KareemRefai/Embedded-Project-Group-8/pic1.jpg

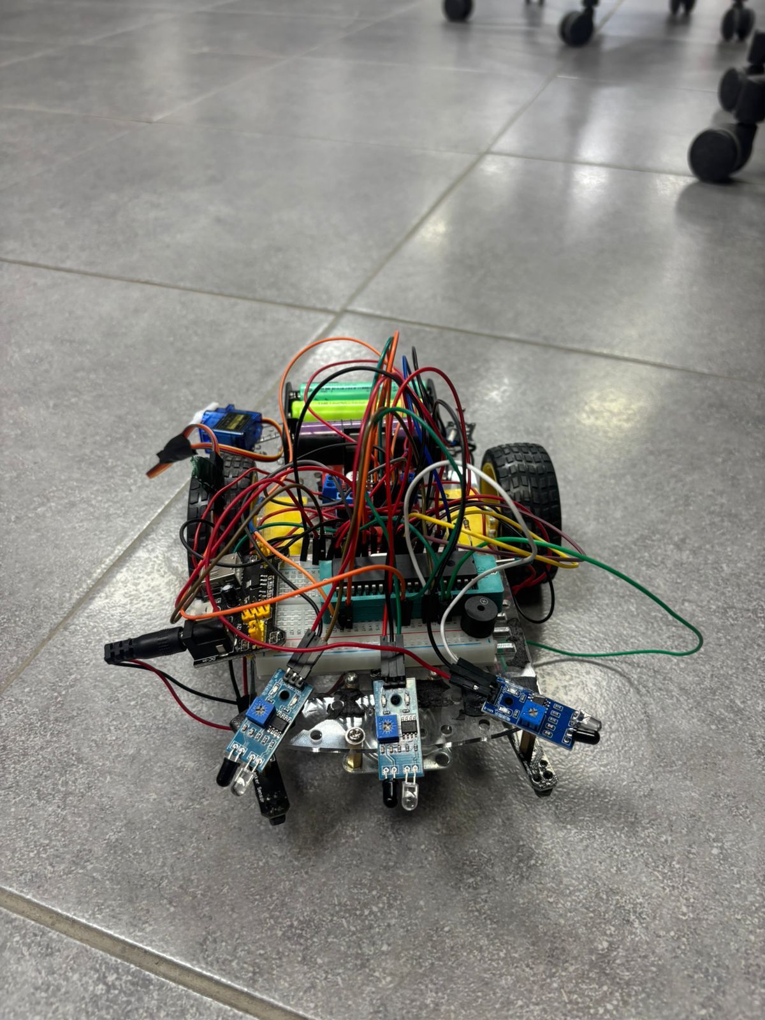
pic1.jpg
