KareemRefai/Embedded-Project-Group-8/pic2.jpg

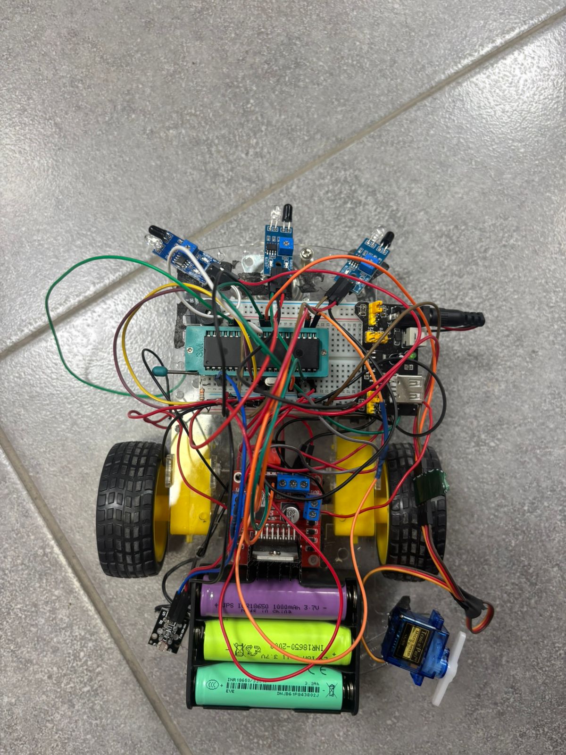
pic2.jpg
