KareemRefai/Embedded-Project-Group-8/EmbeddedActualFinalCodeForGroup8.c

void manual_delay(unsigned int d) {
    unsigned int i;
    for(i = 0; i < d; i++) {

    }
}
void timer1_delay_us(unsigned int us) {
    unsigned int preload; // initial count value

    T1CON = 0x10;          //Timer1 OFF, internal clock, prescaler 1:2

    preload = 65536 - us; //count to 2^16 before overflow

    TMR1H = preload / 256; //high byte, Timer1 high
    TMR1L = preload % 256; //low byte, Timer1 Low

    PIR1 = PIR1 & 0xFE;    //clear bit 0 (TMR1IF)

    T1CON = T1CON | 0x01;  //set bit 0 (TMR1ON)

    while((PIR1 & 0x01) == 0);

    T1CON = T1CON & 0xFE;  //clear bit 0 (T1CON)
}

unsigned int servo_i;


// ================= ADC FOR LDR ON RA1 / AN1 =================
void ADC_Init_LDR_RA1() {
    ADCON1 = 0x80; //PORTA analog inputs (right justified)
    ADCON0 = 0x49; //RA1 selected
}

unsigned int read_ldr_RA1() {
    ADCON0 = 0x49;
    manual_delay(20); //charge capacitor

    ADCON0 = ADCON0 | 0x04; //start ATD conversion

    while(ADCON0 & 0x04);

    return ((unsigned int)ADRESH * 256) + ADRESL;
}


// ================= PWM INIT =================
// ENA = RC1 = CCP2
// ENB = RC2 = CCP1

void CCPPWM_init(void) {
    TRISC = TRISC & 0xF9;

    PR2 = 250; //set pwm period register

    CCP1CON = 0x0C;
    CCP2CON = 0x0C;

    CCPR1L = 0;
    CCPR2L = 0;

    T2CON = 0x07; //start Timer2, prescaler 1:16, enable pwm signals
}


// ================= MOTOR SPEED =================

void motor_R(unsigned char speed) {
    CCPR1L = speed;
}

void motor_L(unsigned char speed) {
    CCPR2L = speed;
}


// ================= MOTOR CONTROL =================
// IN1 = RD0
// IN2 = RD1
// IN3 = RD2
// IN4 = RD3

void stop_motors() {
    PORTD = PORTD & 0xF0; //clear RD0-RD3, turn off direction

    motor_L(0);
    motor_R(0);
}

void forward() { //RD0 = 1,RD2 = 1

    PORTD = PORTD | 0x05;
    PORTD = PORTD & 0xF5;

    motor_L(55);
    motor_R(55);
}

void turn_left() {

    PORTD = PORTD | 0x01;   //RD0 = 1
    PORTD = PORTD & 0xF1;   //RD1, RD2, RD3 = 0

    motor_L(60);
    motor_R(0);
}

void turn_right() {
    PORTD = PORTD | 0x04;   //RD2 = 1
    PORTD = PORTD & 0xF4;   //RD0, RD1, RD3 = 0

    motor_L(0);
    motor_R(60);
}
void turn_right1() { //RD0,RD2 = 1

     PORTD = PORTD | 0x05;
    PORTD = PORTD & 0xF5;

    motor_L(45);
    motor_R(65);
}
void hard_right() { //RD1,RD2 = 1
    PORTD = PORTD & 0xF0;
    PORTD = PORTD | 0x06;

    motor_L(70);
    motor_R(70);
}

void raise_servo_RD6() {

    for(servo_i = 0; servo_i < 100; servo_i++) {
        PORTD = PORTD | 0x40; //turn RD6 high
        timer1_delay_us(2000);
        PORTD = PORTD & ~0x40; //turn RD6 low
        timer1_delay_us((unsigned int)(20000 - 2000));
   }
}

void main() {
    unsigned int ldr_value;

    unsigned char sensor_R;
    unsigned char sensor_L;
    unsigned char obstacle_ir;
    unsigned char obstacle_ir1;
    unsigned char obstacle_irm;
    TRISC = TRISC & 0xF9;

    TRISD = 0xA0;

    TRISB = TRISB | 0x0E;
    TRISB = TRISB & 0x7F; //buzzer

    TRISA = TRISA | 0x02;

    PORTD = 0x00;
    PORTB = PORTB & 0x7F;

    ADC_Init_LDR_RA1();
    CCPPWM_init();

    stop_motors();


    while(1) {
        ldr_value = read_ldr_RA1();
        while((PORTB & 0x80) == 0){    //while buzzer off
        ldr_value = read_ldr_RA1();
        if(ldr_value > 270) {
            PORTB = PORTB | 0x80;
        }
        else {
            PORTB = PORTB & 0x7F;
        }

            //Line tracking

            sensor_R = PORTB & 0x04; //RB2
            sensor_L = PORTB & 0x08; //RB3

            if (sensor_R != 0 && sensor_L != 0) {
                forward();
            }
             if (sensor_R != 0 && sensor_L == 0) {
               turn_left();
            }
             if (sensor_R == 0 && sensor_L != 0) {
            turn_right();

            }
             if (sensor_R == 0 && sensor_L == 0) {
                stop_motors();
                manual_delay(2000);

                turn_left();
                manual_delay(130000);
            }

        }

    while((PORTB & 0x80) != 0){//while buzzeer on
        ldr_value = read_ldr_RA1();
        if(ldr_value > 240) {
            PORTB = PORTB | 0x80;
        }
        else {
            PORTB = PORTB & 0x7F;
        }


            sensor_R = PORTB & 0x04;
            sensor_L = PORTB & 0x08;

            if (sensor_R != 0 && sensor_L != 0) {
                forward();
            }
             if (sensor_R != 0 && sensor_L == 0) {
               turn_left();
            }
             if (sensor_R == 0 && sensor_L != 0) {
            turn_right();

            }

        }

        //Maze Navigation
     while(1){

     PORTB = PORTB & 0x7F; //buzzer off
     sensor_R = PORTB & 0x04;
     sensor_L = PORTB & 0x08;
       obstacle_ir = PORTB & 0x02; //right IR
       obstacle_ir1 = PORTB & 0x01; //left IR
       obstacle_irm = PORTD & 0x80; //center IR
       if(obstacle_irm == 0){
        turn_left(); }
        else
        if(obstacle_ir == 0 && obstacle_irm != 0){
        turn_left(); }
        else if(obstacle_ir1 == 0 && obstacle_irm != 0) {
           turn_right();
        }
        else if(obstacle_ir1 == 0 && obstacle_irm == 0 ){
           hard_right();
        }
        else if (sensor_R == 0 && sensor_L == 0) {
        break;
            }
           else{ turn_right1();
                                  }



     }
     while(1){
     obstacle_ir = PORTB & 0x02;
     obstacle_ir1 = PORTB & 0x01;
     obstacle_irm = PORTD & 0x80;
     if(obstacle_irm == 0){
     stop_motors();
     raise_servo_RD6();
      while(1)stop_motors();
         }
           else if(obstacle_ir == 0) {
           turn_left();
        }
         else{ turn_right1();
     }
}
}}
